Celeautech-Lab/arcade-cabinet/CAD/STEP/cabinet_top_asm.stp

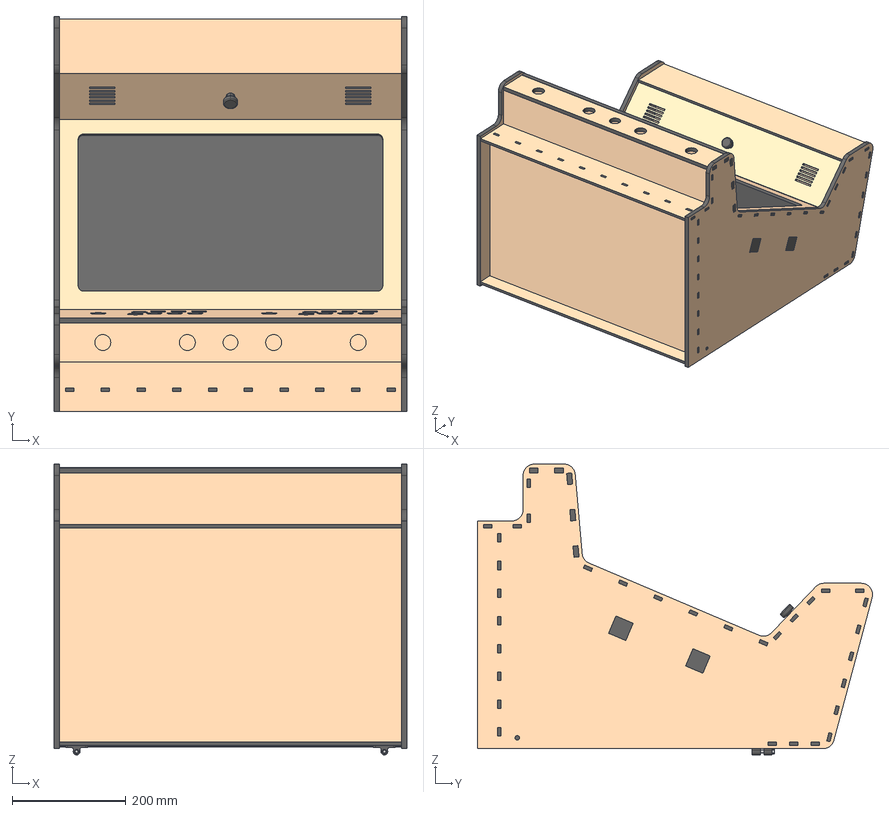
[picture p12: CAD file, 2026-10-20]
CAD/STEP/cabinet_top_asm.stp
620.0 x 693.9 x 511.0 mm
LEFT_PANEL
BACK_PANEL
TOP_PANEL
TOP_BACK_PANEL
MARQUEE
SCREEN_PANEL
UNDER_TOP_PANEL
CONTROL_PANEL
FRONT_CONTROL_PANEL
UNDER_CONTROL_PANEL
FRONT_PANEL
SCREEN
SCREEN_SUPPORT
SCREEN_SUPPORT_BAR x 2
BOTOM_PANEL
BACK_PANEL_SUPPORT
BACK_PANEL_LATCH x 3
BACK_PANEL_LOCKER x 4
LOCKER_PIN x 2
RIGHT_PANEL
VOLUME_BUTTON
