Celeautech-Lab/arcade-cabinet/CAD/3MF/volume_button.3mf

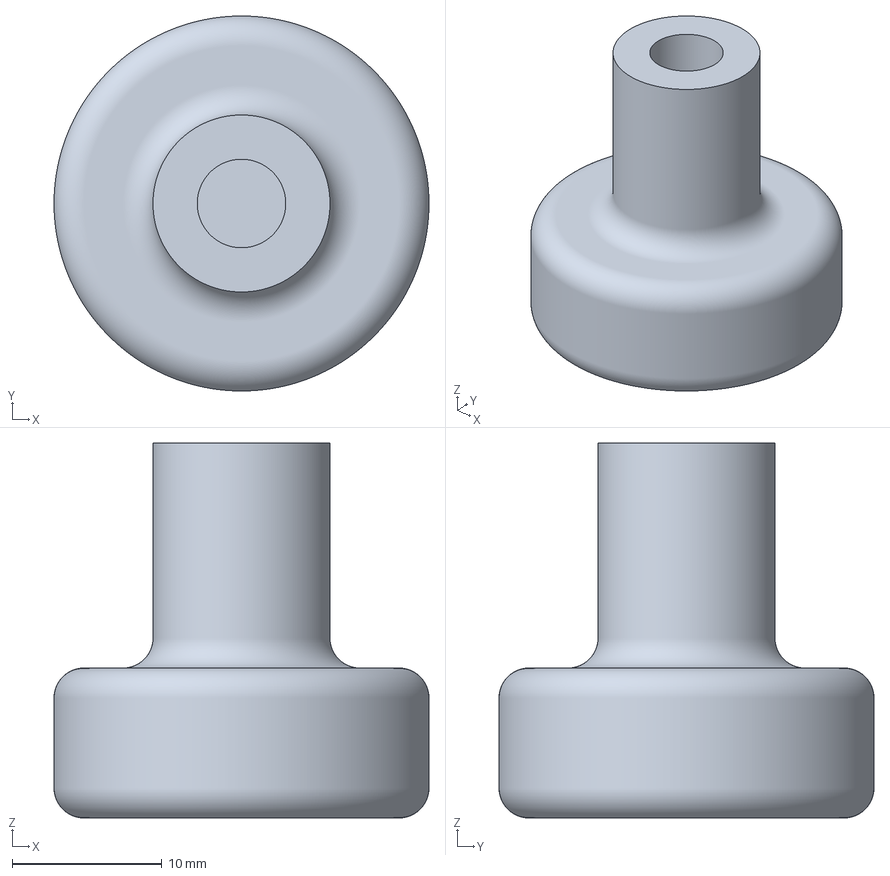
[picture p13: CAD file, 2026-10-20]
CAD/3MF/volume_button.3mf
25.0 x 25.0 x 25.0 mm
