Celeautech-Lab/arcade-cabinet/CAD/3MF/back_panel_latch.3mf

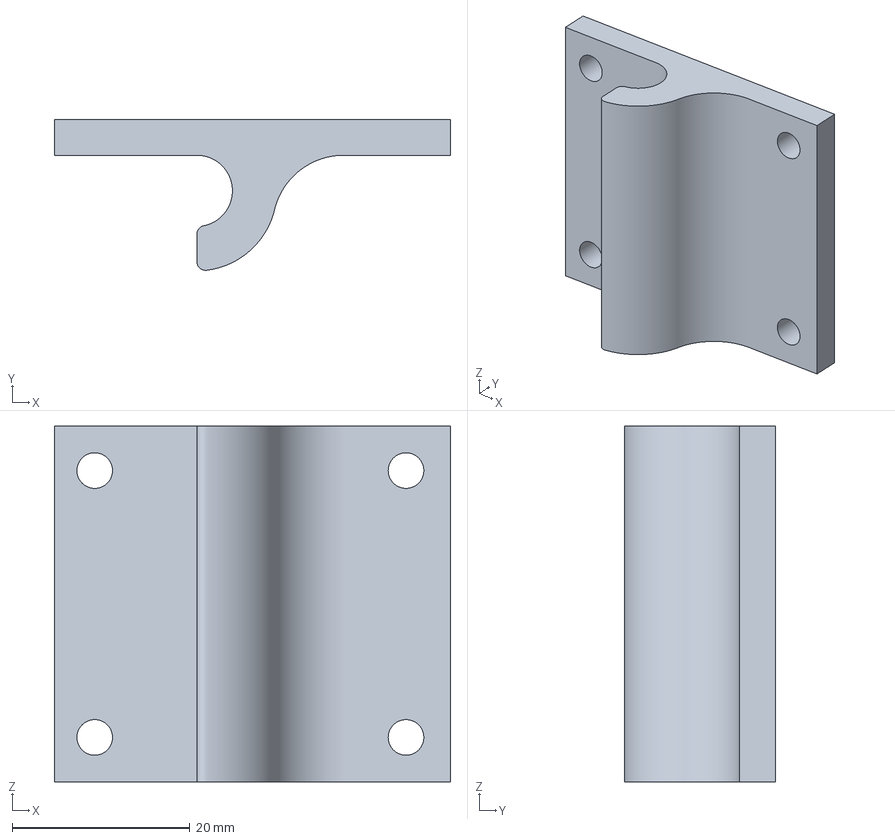
[picture p15: CAD file, 2026-10-20]
CAD/3MF/back_panel_latch.3mf
44.5 x 16.9 x 40.0 mm
