Celeautech-Lab/arcade-cabinet/CAD/3MF/back_panel_locker.3mf

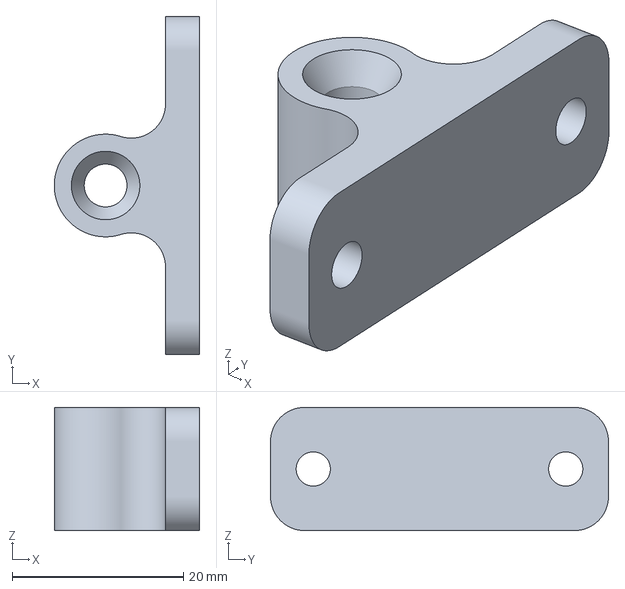
[picture p17: CAD file, 2026-10-20]
CAD/3MF/back_panel_locker.3mf
17.0 x 39.5 x 14.4 mm
