Celeautech-Lab/arcade-cabinet/CAD/DXF/under_control_panel.dxf

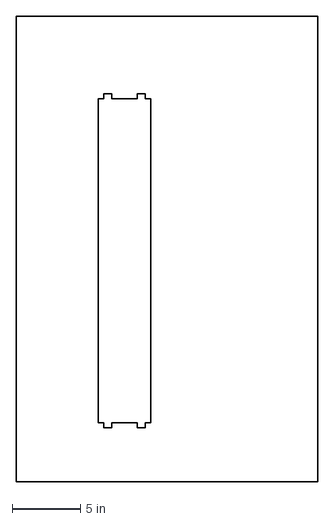
[picture p18: CAD file, 2026-10-20]
CAD/DXF/under_control_panel.dxf
22.0 x 34.0 in
