Celeautech-Lab/arcade-cabinet/CAD/DXF/bottom_panel.dxf

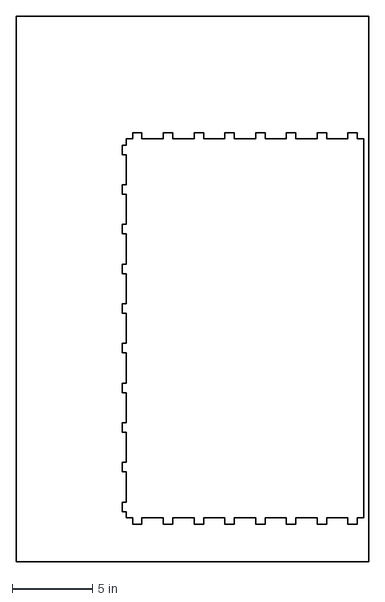
[picture p19: CAD file, 2026-10-20]
CAD/DXF/bottom_panel.dxf
22.0 x 34.0 in
