Celeautech-Lab/arcade-cabinet/CAD/DXF/screen_support.dxf

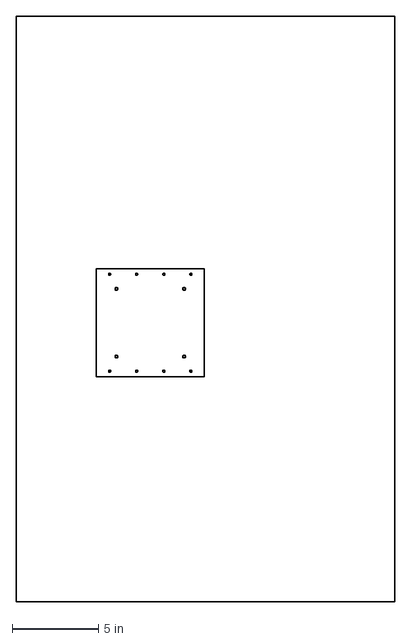
[picture p20: CAD file, 2026-10-20]
CAD/DXF/screen_support.dxf
22.0 x 34.0 in
