Celeautech-Lab/arcade-cabinet/CAD/DXF/marquee.dxf

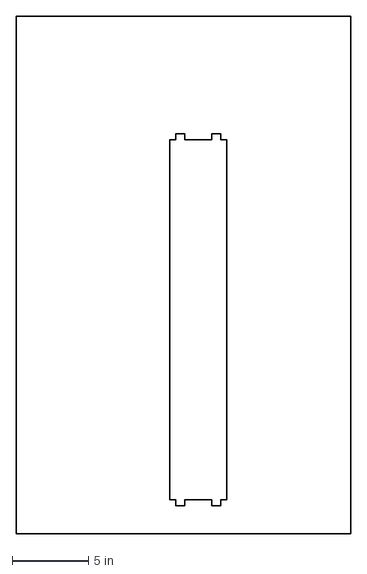
[picture p22: CAD file, 2026-10-20]
CAD/DXF/marquee.dxf
22.0 x 34.0 in
