Celeautech-Lab/arcade-cabinet/CAD/DXF/left_panel.dxf

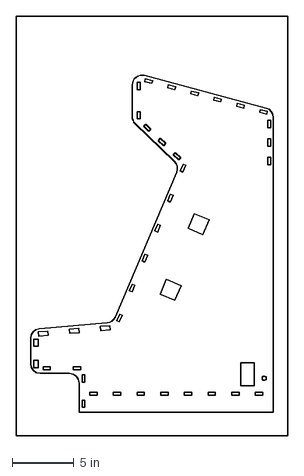
[picture p23: CAD file, 2026-10-20]
CAD/DXF/left_panel.dxf
22.0 x 34.0 in
