Celeautech-Lab/arcade-cabinet/CAD/DXF/screen_panel.dxf

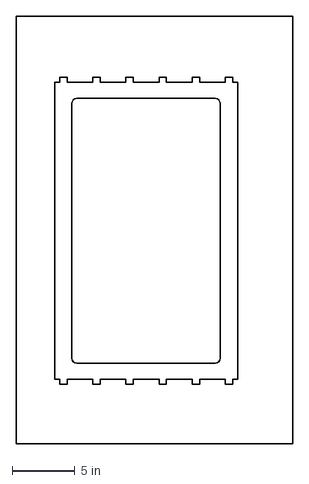
[picture p24: CAD file, 2026-10-20]
CAD/DXF/screen_panel.dxf
22.0 x 34.0 in
