Celeautech-Lab/arcade-cabinet/CAD/DXF/right_panel.dxf

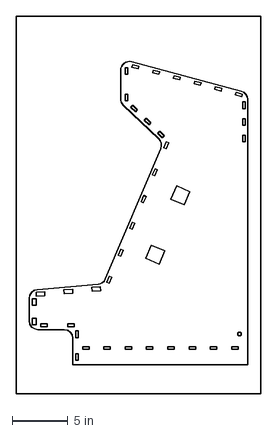
[picture p25: CAD file, 2026-10-20]
CAD/DXF/right_panel.dxf
22.0 x 34.0 in
