Celeautech-Lab/arcade-cabinet/CAD/DXF/control_panel.dxf

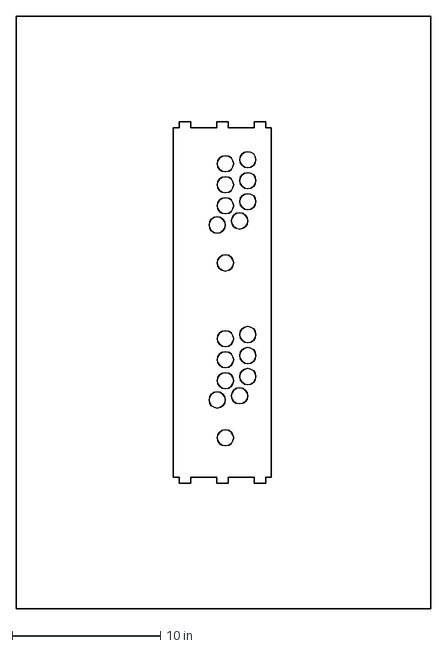
[picture p26: CAD file, 2026-10-20]
CAD/DXF/control_panel.dxf
28.0 x 40.0 in
