Celeautech-Lab/arcade-cabinet/CAD/DXF/back_panel.dxf

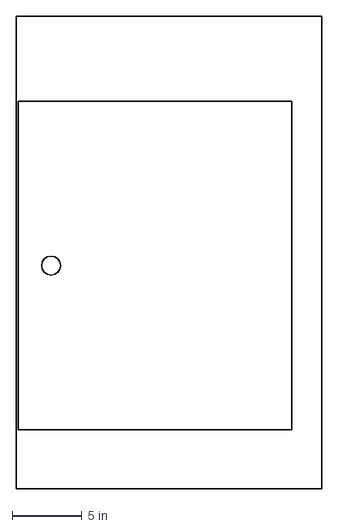
[picture p27: CAD file, 2026-10-20]
CAD/DXF/back_panel.dxf
22.0 x 34.0 in
