Celeautech-Lab/arcade-cabinet/CAD/DXF/top_back_panel.dxf

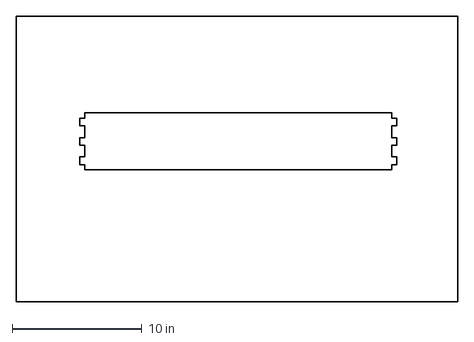
[picture p28: CAD file, 2026-10-20]
CAD/DXF/top_back_panel.dxf
34.0 x 22.0 in
