Celeautech-Lab/arcade-cabinet/(list of files, cad)

Other CAD files:
CAD/DXF/top_panel.dxf
