Celeautech-Lab/arcade-cabinet/(commit log)

2026-10-20 adding STEP assembly file, LICENSE file
    [cabinet_asm.stp]
2026-10-20 adding empty BOM and front_view from CAD
2026-10-20 added BOM and wiring diagram
2026-10-20 Update monitor model in BOM.md
2026-10-20 Revise BOM for electronics and hardware components
    Updated the Bill of Materials (BOM) with detailed specifications and notes for each component, including clarifications on sizes and compatibility.
2026-10-20 Fix wiring diagram link in BOM.md
    Updated the wiring diagram link in the BOM.
2026-10-20 add DXF/3MF manufacturing files, project photos, and update STEP assembly
    - Add laser-cutting DXF files and 3D-printing 3MF files
    - Update full STEP assembly
    - Add CAD renders and real build photos
    - Move wiring diagram to the new assets directory
    [back_panel.dxf, back_panel_latch.3mf, back_panel_locker.3mf, botom_panel.dxf, cabinet_asm.stp, cabinet_top_asm.stp, control_panel.dxf, front_control_panel.dxf]
2026-10-20 Fix wiring diagram link in BOM.md
    Updated the wiring diagram link from 'Electronics' to 'Media'.
2026-10-20 Revise BOM structure and content
    Updated the Bill of Materials (BOM) to enhance clarity and organization, including new sections for hardware and DIY fabricated parts.
2026-10-20 Revise BOM with detailed specifications and formatting
    Updated the Bill of Materials (BOM) to include detailed specifications and additional components for electronics and hardware. Improved formatting for clarity and organization.
2026-10-20 Revise BOM for Raspberry Pi and assembly components
    Updated Raspberry Pi installation notes and added details for M5 machine screws, wooden dowel, and wooden battens.
2026-10-20 Fix file name typo for bottom_panel.dxf
    [bottom_panel.dxf]
2026-10-20 Add wood screws for screen support
    Added wood screws for screen support to BOM.
2026-10-20 Update README with project details and instructions
    Added detailed project description, specifications, and assembly instructions for a 2-player bartop arcade cabinet powered by Raspberry Pi running Recalbox.
2026-10-20 Update BOM.md for component specifications
2026-10-20 Clarify hardware specifications and player options
    Updated README to specify Raspberry Pi 3B+ and clarify player capabilities.
